fuszenecker/DiplomaThesis/CD/Fuszenecker_R_ajljxa_2009/Összefoglalás.rtf

Nagyteljesítményű vészhelyzeti áramforrás tervezése
Összefoglalás
Ez a dolgozat azért született, hogy leírjam, miként terveztem és valósítottam meg a specifikációban meghatározott DC/DC konvertert és az ahhoz szorosan kapcsolódó ellenőrző-irányító rendszert.
Maga a DC/DC konverter egy kapcsoló üzemű, push-pull felépítésű áramhatárolt feszültséggenerátor, amely amellett, hogy a bejövő 240-300 V-os DC feszültségből 300 V DC-t állít elő a kimenetén, távolról irányítható is egy felhasználói program, vagy más vezérlő segítségével. Energiatárolásra szuperkapacitásokat használok, melyek tulajdonképpen igen nagy kapacitású kondenzátorok. A tárolt energia értéke könnyen kiszámítható a szakdolgozatom 4. fejezetében található képletek segítségével. Normál üzemben a szuperkapacitás blokkot egy megfelelően felépített tápegység, mint feszültséghatárolt áramgenerátor tölti. A dolgozat fő témája ennek a DC/DC konverternek (átalakítónak) a megtervezése és megépítése.
A tápegység egyik legkritikusabb eleme a transzformátor, ez transzformálja a bejövő feszültséget a kívánt szintre. Méretezése rendkívül fontos részét képezi a dolgozatnak. A transzformátor által előállított AC feszültséget egyenirányítani és szűrni kell, hogy végül DC feszültség jelenhessen meg a konverter kimenetén. Az átalakító kimenete szuperkapacitásokra kapcsolódik, a töltőáram és a kondenzátorok kapocsfeszültségét figyelembe véve a mikrovezérlő elvégzi a szabályozást.
Az elkészített berendezés egy vészhelyzeti tápenergia-ellátás része, így gondosan kell megválasztani az áramkör részegységeit és a kommunikációs buszt. A kommunikáció megvalósításához a CAN buszt használom, mert a mikrovezérlő beépített CAN vezérlője elvégzi a keretezést, a bejövő üzenetek szűrését, priorizálását. Emellett a CAN gondoskodik arról is, hogy a kommunikáció megbízható legyen, tehát a nem nyugtázott üzenetek újraküldését automatikusan elvégzi.
Mind a DC/DC konverterben, mind a soros-CAN átalakítóban az ARM Cortex-M3 típusú processzort használom. Azért választottam az ARM-ot, mert de facto szabvány a 32 bites beágyazott alkalmazások körében, kiváló a támogatottsága (C/C++ fordító, programozó szoftver, fórumok), számos gyártó ajánl ARM magos mikrovezérlőt (ST, Luminary, ATMEL, Zilog, NXP, Texas, stb.), és a Linux is lefordítható ARM processzorra. Az ARM Cortex-M3 mag használata mellett szól az az érv is, hogy nagy teljesítményű, kifejezetten mikrovezérlőt alkalmazó beágyazott rendszerek számára fejlesztették ki, a lapkagyártók pedig számos perifériával látták el, így jelenleg a technológia csúcsát képviseli. CAN vezérlő is helyet kapott a perifériák között: természetesen magam is a mikrovezérlő beépített CAN kontrollerét használom mind a soros-CAN átalakító megvalósításához, mind a DC/DC konverter megépítéséhez.
Bátran állíthatom, hogy az elkészült áramkör a specifikációban megfogalmazott igényeket maradéktalanul kielégíti, sőt, bőven túl is teljesíti azokat.

Design of a high-power
emergency supply
Abstract
I wrote this document to show, how I designed and realized a high-power DC/DC converter and it's control system specified in the first chapter of my diploma thesis.
The DC/DC converter is a current-limited switching mode voltage source using push-pull architecture. This generator, which converts the incoming 240-300 V DC voltage to 300 V, can be remotely controlled with a user program or an other controller. Supercapacitors have been used to store energy. Theoretically, they are normal capacitors with very big capacitance. The stored energy can be calculated using the equations that can be seen in the 4th chapter of the thesis. In normal cases the supercapacitor blocks are charged by a well-designed power supply, which is a voltage limited current source. The topic of this diploma thesis is to design and build this power source.
One of the most critical components of the converter is the transformer, that transforms the input voltage to the desired output value. The design of this transformer is a very important part of the dissertation. The AC voltage provided by the transformer has to be rectified and filtered, so that the DC voltage can appear on the output of the DC/DC converter. The output of the converter has been connected to the terminals of the supercapacitors, thus the microcontroller can do the regulation according to the charging current and the voltage of the capacitors.
This equipment will be a part of an emergency power supply, so the components of the circuit and the communication bus have to be chosen carefully. To realize the communication method I use the CAN bus, because the built-in controller of the ARM processor can do the framing automatically, filters the input messages, and priorizes them. The CAN also provides a reliable communication, because it resends the not acknowledged frames.
Both the DC/DC converter and the serial-CAN interface uses an ARM Cortex-M3 processor based microcontroller. It was a really good choice, because it is the de facto standard among the 32-bit embedded applications. It has an excellent support (C/C++ compiler, programming and debugging software, forums), several chip manufacturers provides ARM based microcontrollers (ST, Luminary, ATMEL, Zilog, NXP, Texas, etc.), also the Linux can be compiled for ARM architecture. It's fruitful to use the ARM Cortex-M3 core, because of its high performance, and the manufacturers integrated the core with a couple of peripherals, so the ARM Cortex-M3 represents the top of the technology. Also the CAN controller has been integrated into the microcontroller chip, that's why I used the built-in CAN peripheral as a communication interface.
I can bravely declare that the circuit accords to the specification described in the first chapter of my diploma thesis. Moreover, it eclipses the specification.
