fuszenecker/DiplomaThesis/Presentation/Presentation.pdf

Nagyteljesítményű vészhelyzeti áramforrás tervezése

## Nagy teljesítményű vészhelyzeti áramforrás tervezése

Fuszenecker Róbert
2009. február 25.
Készítette: Fuszenecker Róbert 2009-ben. | 1 / 29

Nagyteljesítményű vészhelyzeti áramforrás tervezése

## A feladat megfogalmazása

Az EADS¹
specifikációjának megfelelően készítendő egy vészhelyzeti áramforrás, mely
az elsődleges áramforrás kimaradása esetén átveszi annak funkcióját:
10 kW terhelést
legalább 10 másodpercig táplál
270 VDC névleges bemenő és kimenő feszültség mellett, szuperkapacitásokat tartalmaz,
távolról vezérelhető és ellenőrizhető (CAN buszon keresztül).

1 European Aeronautic Defence and Space Company EADS N.V.

Készítette: Fuszenecker Róbert 2009-ben. | 2 / 29

Nagyteljesítményű vészhelyzeti áramforrás tervezése

## A tápegység felépítése

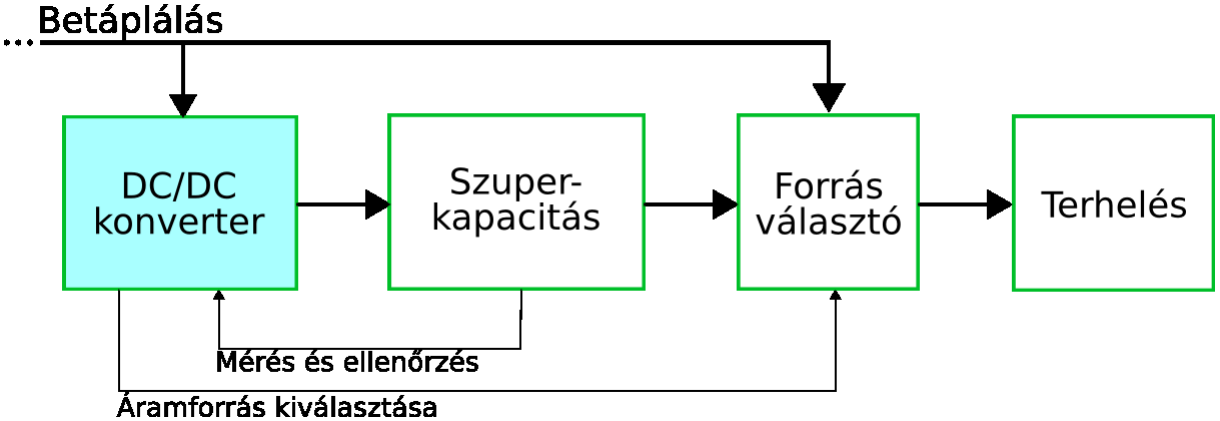
[picture p1: figure]

Készítette: Fuszenecker Róbert 2009-ben. | 3 / 29

Nagyteljesítményű vészhelyzeti áramforrás tervezése

## Részfeladatok

Az áramforrás megvalósításának lépései: tervezés
szuperkapacitás megválasztása töltő-áramkör architektúrájának kiválasztása transzformátor méretezése
áramkör megépítése
soros-CAN átalakító megvalósítása töltő-áramkör megépítése
mérés, ellenőrzés
Készítette: Fuszenecker Róbert 2009-ben. | 4 / 29

Nagyteljesítményű vészhelyzeti áramforrás tervezése

## Szuperkapacitás kiválasztása

A kondenzátorban tárolt energia a következő képlettel számítható:

∫t

# Ptdt=

1
2

⋅C⋅U0

2−U1

2

Az áramkör megépítéséhez egy 6,173 F kapacitású, 300 V-os kondenzátort kell használni. A gyakorlatban ez 5 darab 84 V-os, 100 F-os változattal oldható meg.

Készítette: Fuszenecker Róbert 2009-ben. | 5 / 29

Nagyteljesítményű vészhelyzeti áramforrás tervezése

## A kondenzátorok töltése

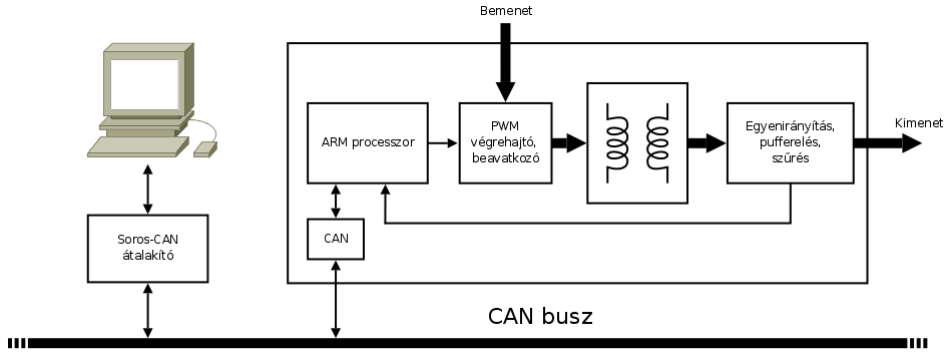
[picture p2: figure]

Az eszköz egy feszültséghatárolt áramgenerátorként vagy áramhatárolt feszültséggenerátorként működik.

Készítette: Fuszenecker Róbert 2009-ben. | 6 / 29

Nagyteljesítményű vészhelyzeti áramforrás tervezése

## Architektúraválasztás

A képen egy push-pull felépítésű, kapcsoló üzemű tápegység látható.

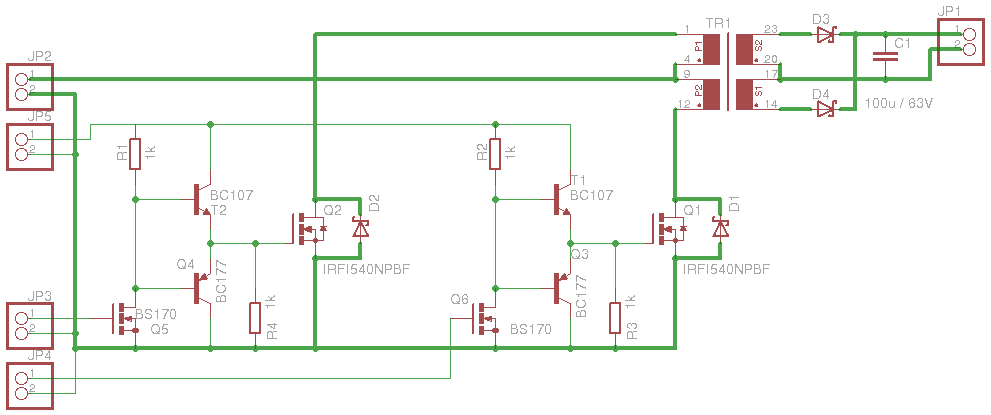
[picture p3: figure]

Készítette: Fuszenecker Róbert 2009-ben. | 7 / 29

Nagyteljesítményű vészhelyzeti áramforrás tervezése

## A kimenő feszültség előállítása

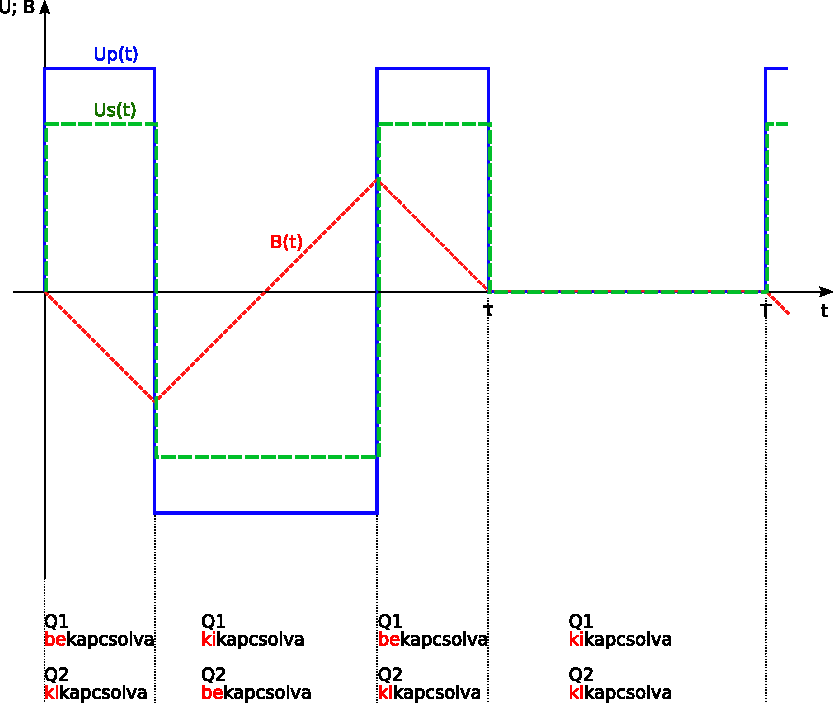
[picture p4: figure]

Készítette: Fuszenecker Róbert 2009-ben. | 8 / 29

Nagyteljesítményű vészhelyzeti áramforrás tervezése

## A kimenő feszültség előállítása (folyt.)

A képen látható jelalakot egy ARM Cortex-M3 alapú mikrovezérlő (STM32F103CBT6) megszakítási rutinja állítja elő, mint szoftver PWM jelet.

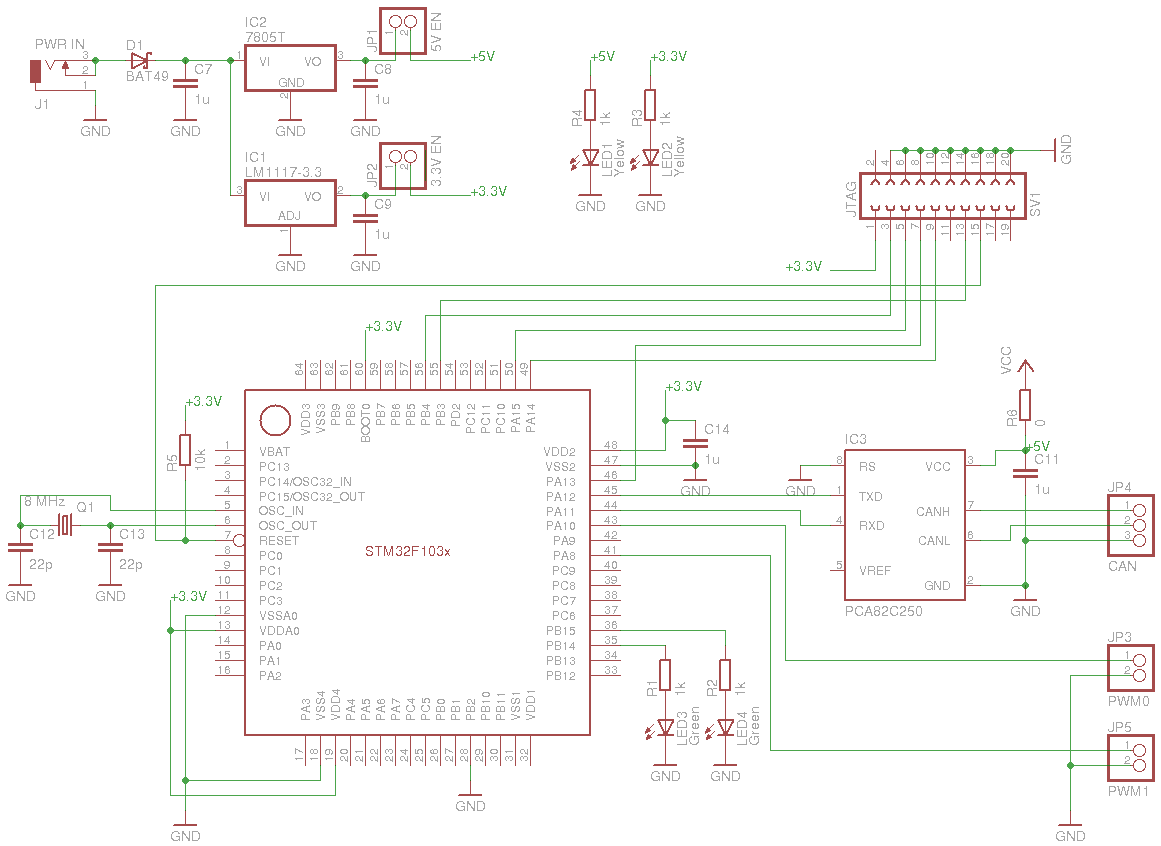
[picture p5: figure]

Készítette: Fuszenecker Róbert 2009-ben. | 9 / 29

Nagyteljesítményű vészhelyzeti áramforrás tervezése

## A transzformátor méretezése

A transzformátor méretezéséhez szükséges összefüggéseket a Maxwell-egyenletekből vezettem le. Ezek közül a legfontosabb:

∮s

H⋅d

s=−

d

# dt ∫A

# Bt⋅d

A

Ez az egyenlet teremt kapcsolatot az indukcióváltozás és az indukált feszültség között.

Készítette: Fuszenecker Róbert 2009-ben. | 10 / 29

Nagyteljesítményű vészhelyzeti áramforrás tervezése

## Az „Y” paraméter

A transzformátor vasmagja jellemezhető egy olyan paraméterrel, amely csak
a primer feszültség jelalakjától,
a maximális indukciótól (katalógusadat), a vasmag keresztmetszetétől
és az alkalmazott frekvenciától
függ:
Y=

Up
Np

=

Us
Ns

=k⋅B

## ⋅A⋅f min

Készítette: Fuszenecker Róbert 2009-ben. | 11 / 29

Nagyteljesítményű vészhelyzeti áramforrás tervezése

## Transzformátorok párhuzamosítása

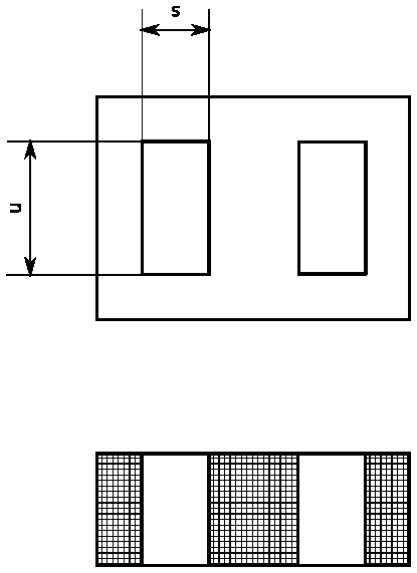
[picture p6: figure]
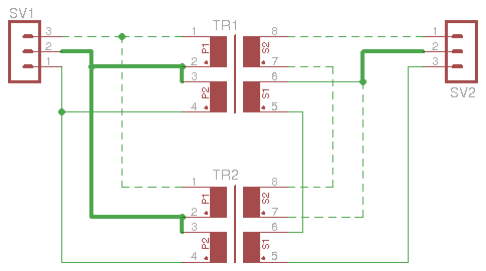
[picture p7: figure]

Erre azért van szükség, mert egy vasmagon nem fér el a teljes tekercselés.

Készítette: Fuszenecker Róbert 2009-ben. | 12 / 29

Nagyteljesítményű vészhelyzeti áramforrás tervezése

## Kommunikáció CAN buszon keresztül

Az áramköröm megvalósításakor a CAN busz alkalmazása mellett döntöttem, mert
viszonylag zavarérzékeny,
nagy átviteli sebességet biztosít (max. 1 Mbit/s),
busz topológia valósítható meg,
a CAN vezérlő tehermentesíti a processzort, mert elvégzi a keretezési feladatokat, pl.:
üzenetprioritás, szűrők
nyugtázás és újrakérés, hibakezelés (vételi puffer megtelt) hibaellenőrzés (CRC)
Készítette: Fuszenecker Róbert 2009-ben. | 13 / 29

Nagyteljesítményű vészhelyzeti áramforrás tervezése

## A CAN protokoll rövid áttekintése

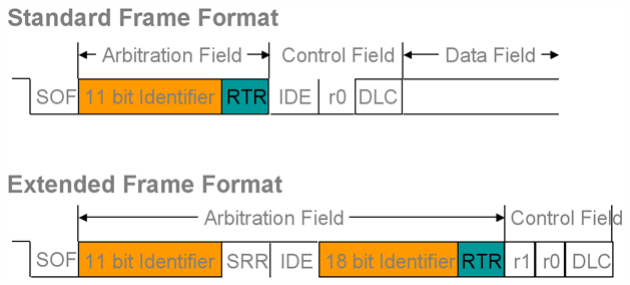
[picture p8: figure]

Készítette: Fuszenecker Róbert 2009-ben. | 14 / 29

Nagyteljesítményű vészhelyzeti áramforrás tervezése

## Busz topológia kialakítása

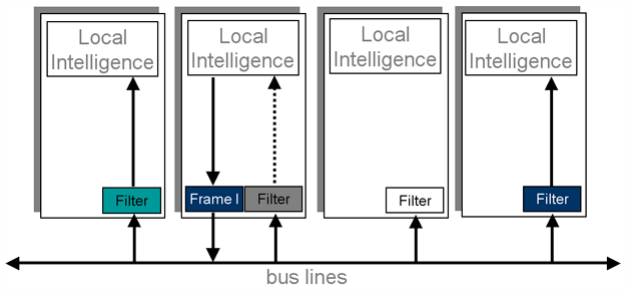
[picture p9: figure]

Készítette: Fuszenecker Róbert 2009-ben. | 15 / 29

Nagyteljesítményű vészhelyzeti áramforrás tervezése

## Az átalakító felépítése

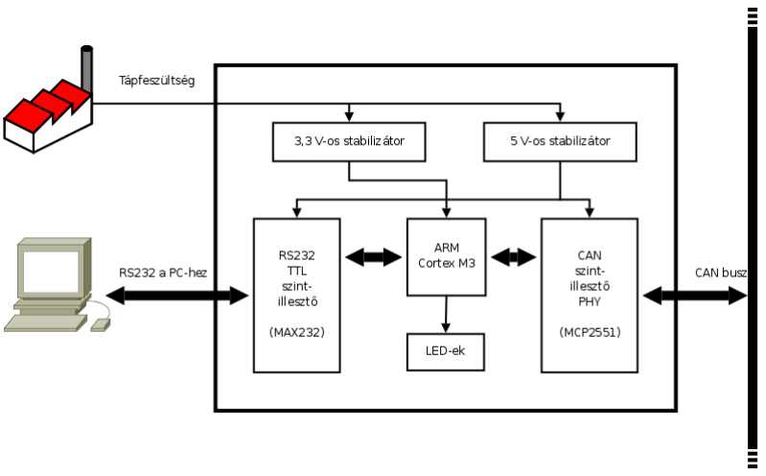
[picture p10: figure]

Készítette: Fuszenecker Róbert 2009-ben. | 16 / 29

Nagyteljesítményű vészhelyzeti áramforrás tervezése

## Az átalakító felépítése (folytatás)

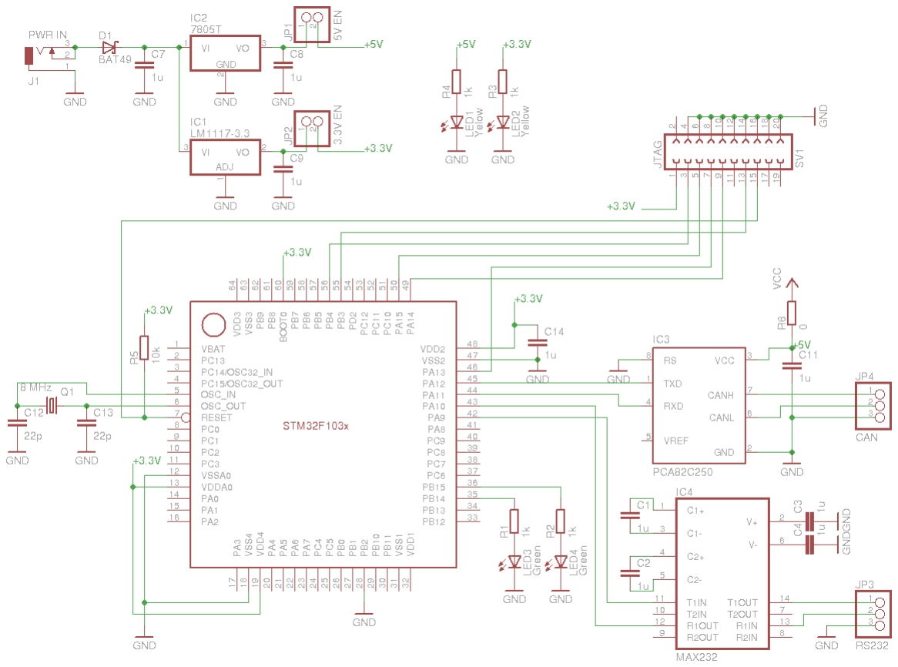
[picture p11: figure]

Készítette: Fuszenecker Róbert 2009-ben. | 17 / 29

Nagyteljesítményű vészhelyzeti áramforrás tervezése

## Az ARM processzor

Mind a tápegység, mind a soros-CAN átalakító megvalósításához egy ARM Cortex-M3 alapú mikrovezérlőt (STM32F103CBT6) használtam a következő okok miatt:
32 bites felépítésű
4 gigabájtos lineáris címtartománnyal rendelkezik (nem kell memóriabankokat és I/O utasításokat használni),
32 bites ARM és 16 bites Thumb utasítások végrehajtására is képes (a Cortex-M3 csak a Thumb2-t ismeri)
a processzor több futtatási módot tartalmaz: lehetőség van a rendszer- és a felhasználói kód szétválasztására. Ez növeli a beágyazott rendszer biztonságát és megbízhatóságát,
Készítette: Fuszenecker Róbert 2009-ben. | 18 / 29

Nagyteljesítményű vészhelyzeti áramforrás tervezése

## Az ARM processzor (folytatás)

számos egységet beépítve tartalmaz: MMU-t, ETM-et, megszakításkezelőt, SYSTICK számlálót,
a gyártók még számos perifériával egészítik ki a processzor magot: számlálókkal, DMA-val, kommunikációs eszközökkel (CAN, Ethernet, USB, USART, I²C, SPI, SD/MMC), A/D és D/A átalakítókkal, stb.,
kiváló szoftveres támogatással rendelkezik: a GCC fordít ARM processzorra, az OpenOCD pedig számos gyártó termékét támogatja.
Firmware library: eszközök kezeléséhez, szabályozástechnikai (pl. PID) és DSP algoritmusok (pl. FIR, IIR, FFT, Speex), TCP/IP és UDP/IP verem
Készítette: Fuszenecker Róbert 2009-ben. | 19 / 29

Nagyteljesítményű vészhelyzeti áramforrás tervezése

## Az ARM Cortex-M3 processzor felépítése

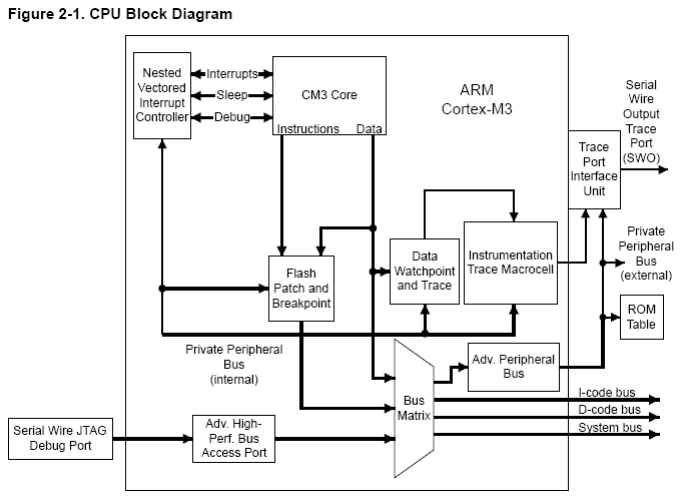
[picture p12: figure]

Készítette: Fuszenecker Róbert 2009-ben. | 20 / 29

Nagyteljesítményű vészhelyzeti áramforrás tervezése

## Az STM32F103CBT6 mikrovezérlő

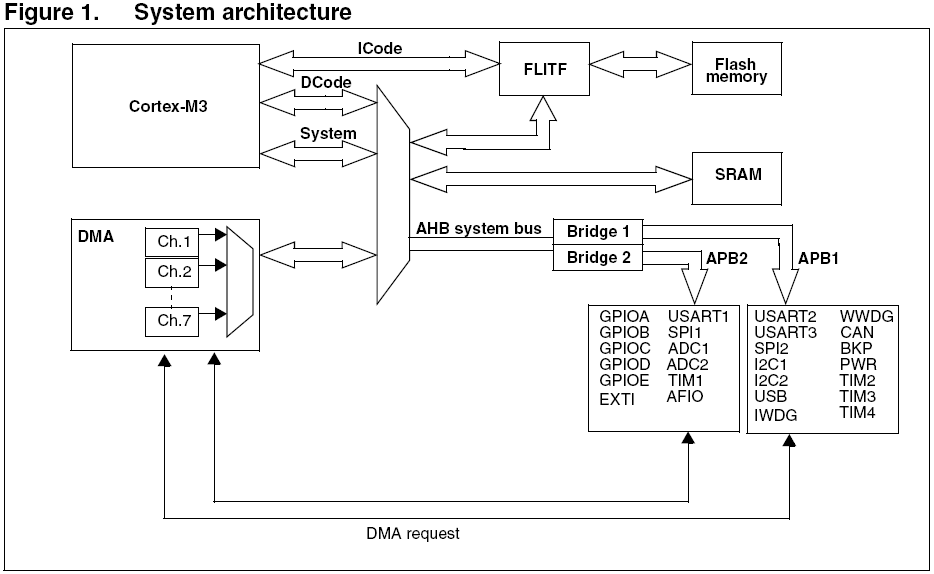
[picture p13: figure]

Készítette: Fuszenecker Róbert 2009-ben. | 21 / 29

Nagyteljesítményű vészhelyzeti áramforrás tervezése

## A szoftverfejlesztés

Az áramforrás és a soros-CAN átalakító elkészítéséhez a következő szoftver eszközöket használtam:
binutils, gcc, make – keresztfordító (cross compiler) a C programok fordításához,
az ST által biztosított függvénykönyvtár a beépített eszközök kezeléséhez,
gdb, openocd – a lefordított kód hibamentesítéséhez,
minicom – a soros-CAN átalakítóval való kommunikációhoz, python – a soros-CAN átalakító felhasználói felületének elkészítéséhez,
ez utóbbi szolgál a tápegységgel való kommunikációhoz is.
Készítette: Fuszenecker Róbert 2009-ben. | 22 / 29

Nagyteljesítményű vészhelyzeti áramforrás tervezése

## A soros-CAN átalakító működés közben

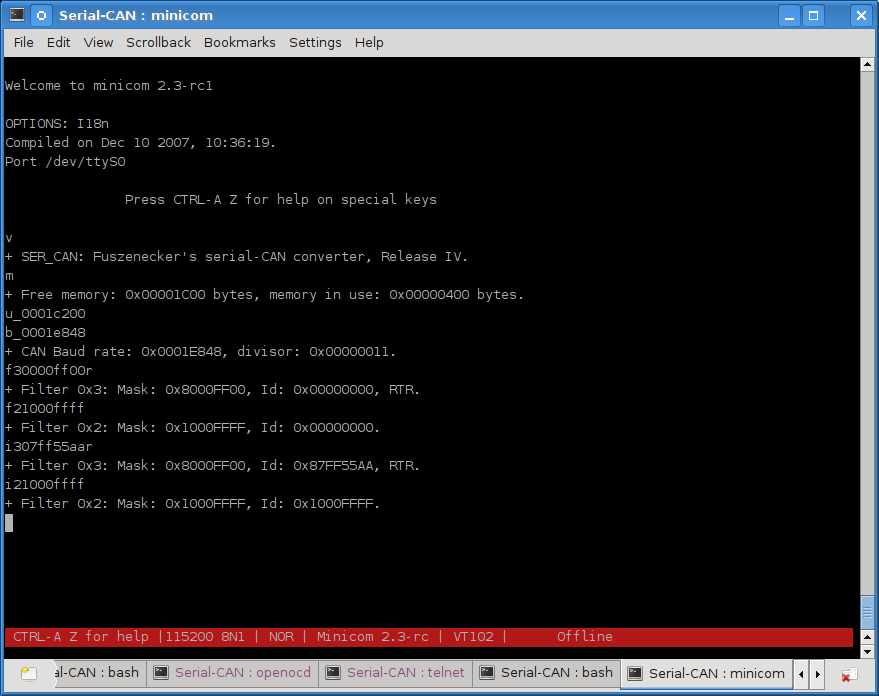
[picture p14: figure]

Készítette: Fuszenecker Róbert 2009-ben. | 23 / 29

Nagyteljesítményű vészhelyzeti áramforrás tervezése

## A grafikus felhasználói felület

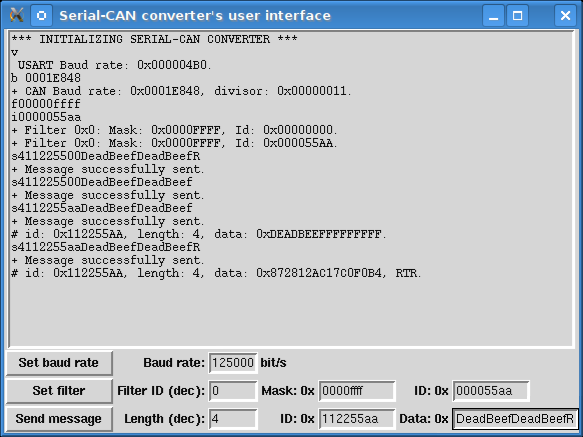
[picture p15: figure]

Készítette: Fuszenecker Róbert 2009-ben. | 24 / 29

Nagyteljesítményű vészhelyzeti áramforrás tervezése

# Van-e kérdés az elhangzottakkal kapcsolatban?

Készítette: Fuszenecker Róbert 2009-ben. | 25 / 29

Nagyteljesítményű vészhelyzeti áramforrás tervezése

# Köszönöm a figyelmet!

Készítette: Fuszenecker Róbert 2009-ben. | 26 / 29

Nagyteljesítményű vészhelyzeti áramforrás tervezése

## Felhasznált szoftverek

OpenOffice.org 2.4.1 – szövegszerkesztő, szövegformázó
GCC 4.2.3 (Sourcery G++ Lite 2008q1-126) – GNU Compiler Collection (GNU fordítógyűjtemény)
Dia 0.96.1 – diagram szerkesztő
Inkscape 0.46 – vektorgrafikus szerkesztő
OpenOCD – Open On-Chip Debugger (nyílt lapkán belüli nyomkövető)
STM32 Firmware Library – STM32 beágyazott programkönyvtár Eagle 5.3.0 Light Edition – nyomtatott áramkör tervező
Készítette: Fuszenecker Róbert 2009-ben. | 27 / 29

Nagyteljesítményű vészhelyzeti áramforrás tervezése

## Felhasznált irodalom

Cortex™-M3 Technical Reference Manual – műszaki referencia kézikönyv
RM0008 STM32 Reference Manual – STM32 referencia kézikönyv http://wikipedia.org/ – A szabad enciklopédia (az ARM processzorok története)
http://www.softing.com – a CAN busz képeinek forrása
Készítette: Fuszenecker Róbert 2009-ben. | 28 / 29

Nagyteljesítményű vészhelyzeti áramforrás tervezése

## Az engedély

Dear Mr Fuszenecker,
we are very pleased that you selected the STM32 for your study. We confirm you hereby that you can use any part of our documentation to illustrate your Report.
We are always interested to see how our product are used. Would it be possible to receive also a copy of your work (or part of it)?

Best regards,
Thomas Ensergueix
Marketing Manager Microcontrollers
Készítette: Fuszenecker Róbert 2009-ben. | 29 / 29
