fuszenecker/DiplomaThesis/Documentation/acknowledge-field.gif

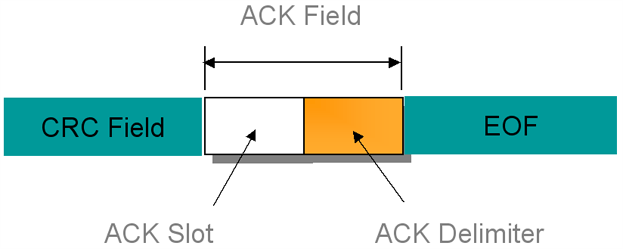
Documentation/acknowledge-field.gif
