fuszenecker/DiplomaThesis/Documentation/arbitration-field.gif

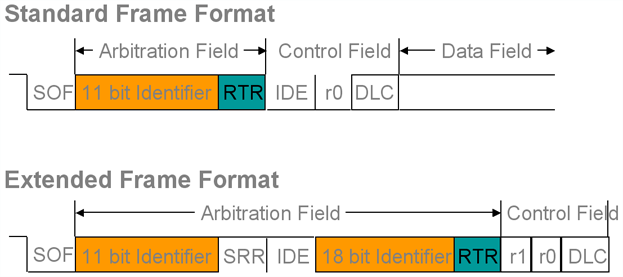
Documentation/arbitration-field.gif
