fuszenecker/DiplomaThesis/Documentation/Arch1.png

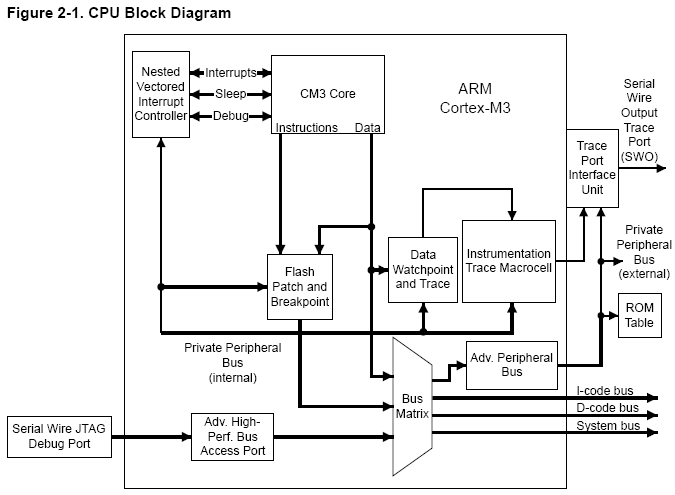
Documentation/Arch1.png
