fuszenecker/DiplomaThesis/Documentation/broadcast-communication.gif

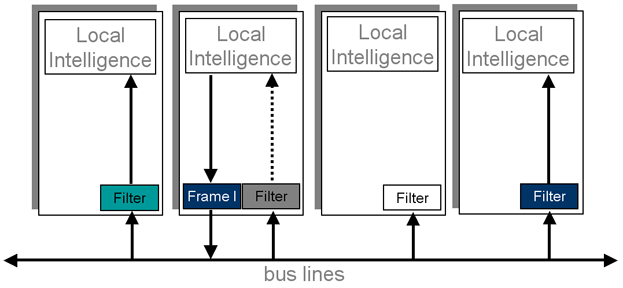
Documentation/broadcast-communication.gif
