fuszenecker/DiplomaThesis/Documentation/BUt.png

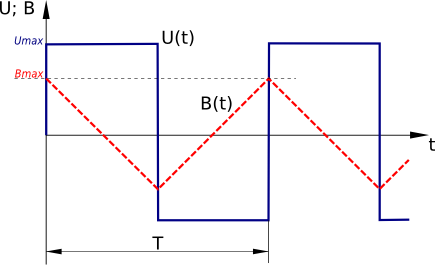
Documentation/BUt.png
