fuszenecker/DiplomaThesis/Documentation/cal.png

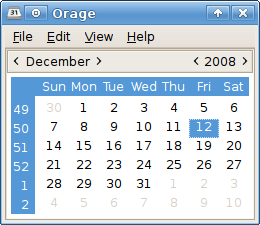
Documentation/cal.png
