fuszenecker/DiplomaThesis/Documentation/Capacitor.png

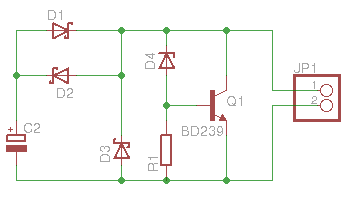
Documentation/Capacitor.png
