fuszenecker/DiplomaThesis/Documentation/data-field.gif

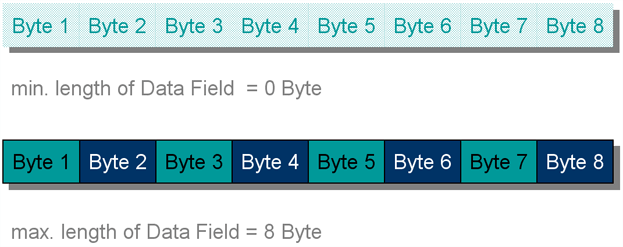
Documentation/data-field.gif
