fuszenecker/DiplomaThesis/Documentation/gdb3.png

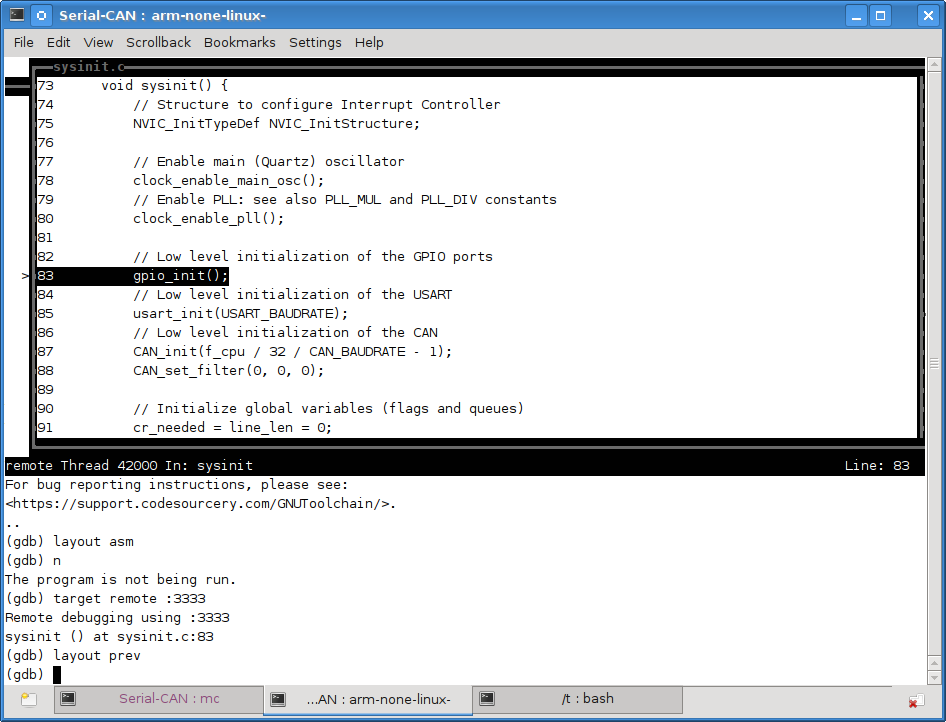
Documentation/gdb3.png
