fuszenecker/DiplomaThesis/Documentation/gdb4.png

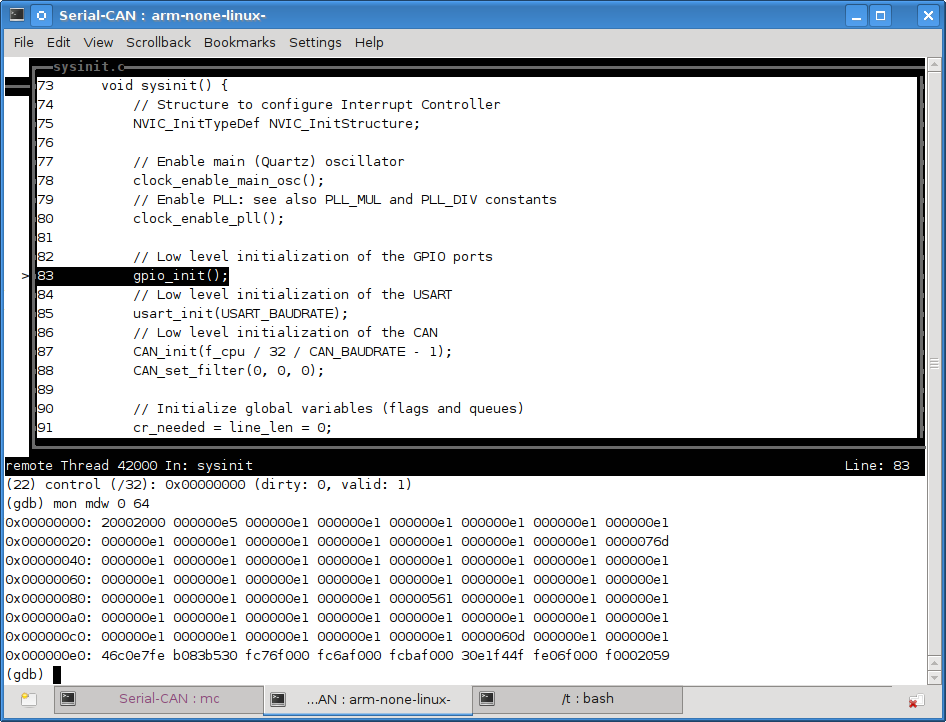
Documentation/gdb4.png
