fuszenecker/DiplomaThesis/Documentation/iso-11992.gif

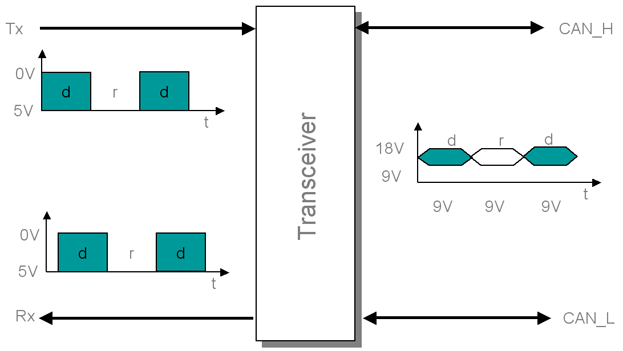
Documentation/iso-11992.gif
