fuszenecker/DiplomaThesis/Documentation/jtagwigglersch.png

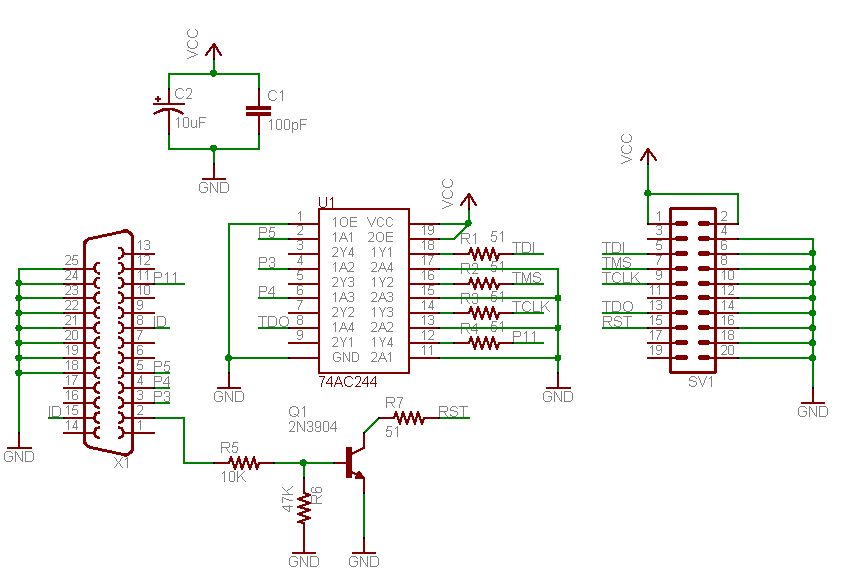
Documentation/jtagwigglersch.png
