fuszenecker/DiplomaThesis/Documentation/lin_bu1.gif

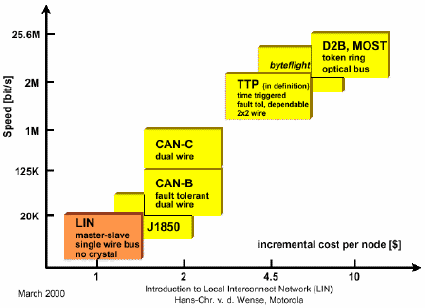
Documentation/lin_bu1.gif
