fuszenecker/DiplomaThesis/Documentation/mini-style-connector.gif

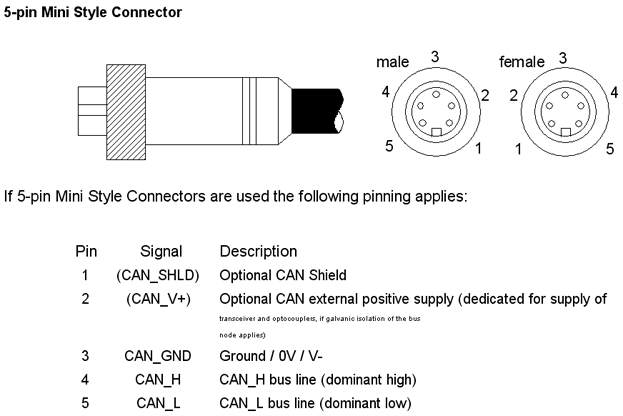
Documentation/mini-style-connector.gif
