fuszenecker/DiplomaThesis/Documentation/Minicom09.png

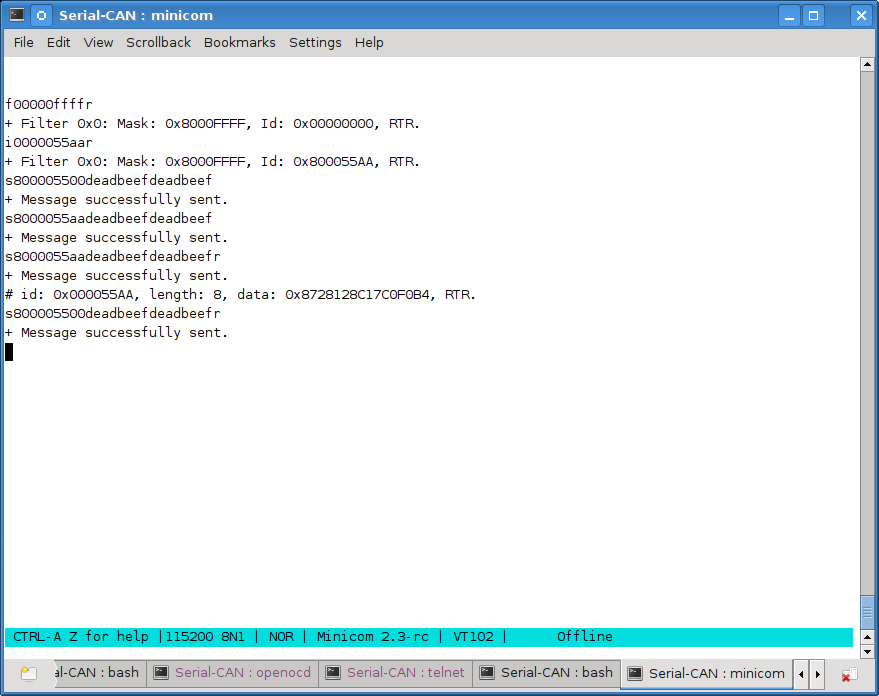
Documentation/Minicom09.png
