fuszenecker/DiplomaThesis/Documentation/Minicom10.png

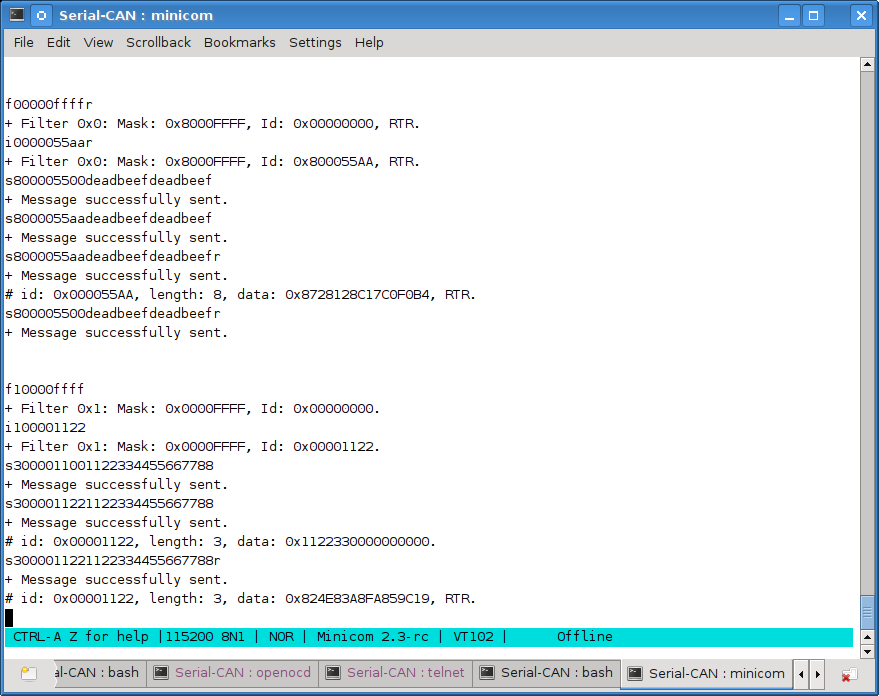
Documentation/Minicom10.png
