fuszenecker/DiplomaThesis/Documentation/Minicom11.png

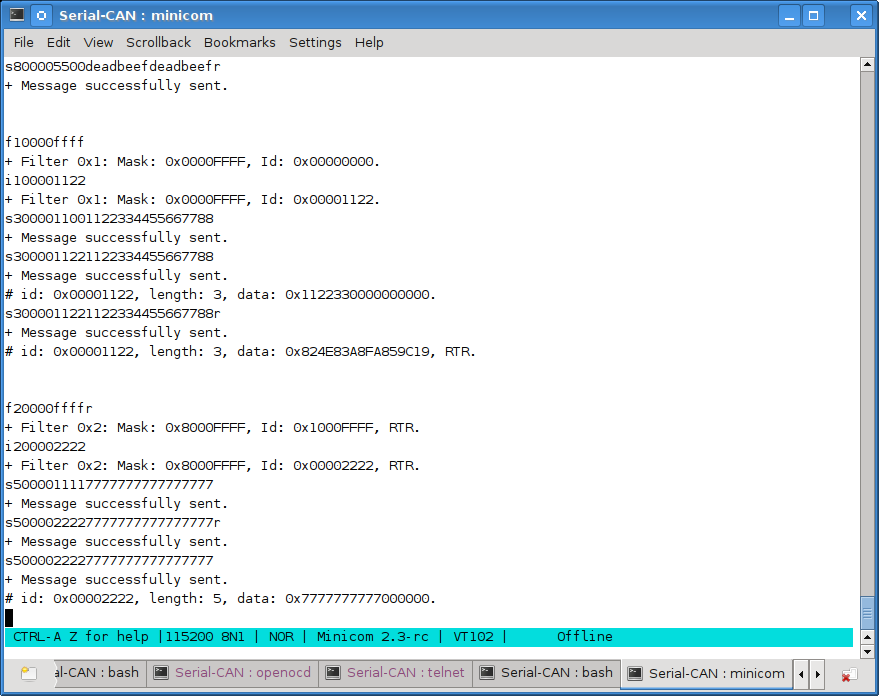
Documentation/Minicom11.png
