fuszenecker/DiplomaThesis/Documentation/multiple-bus-access.gif

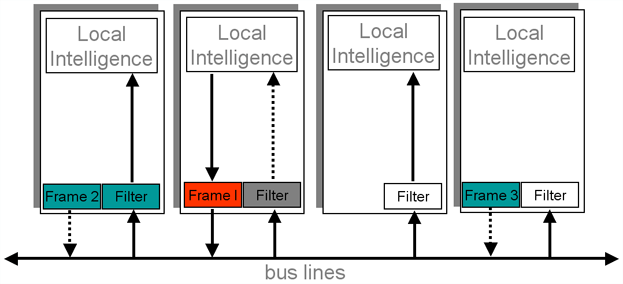
Documentation/multiple-bus-access.gif
