fuszenecker/DiplomaThesis/Documentation/open-style-connector.gif

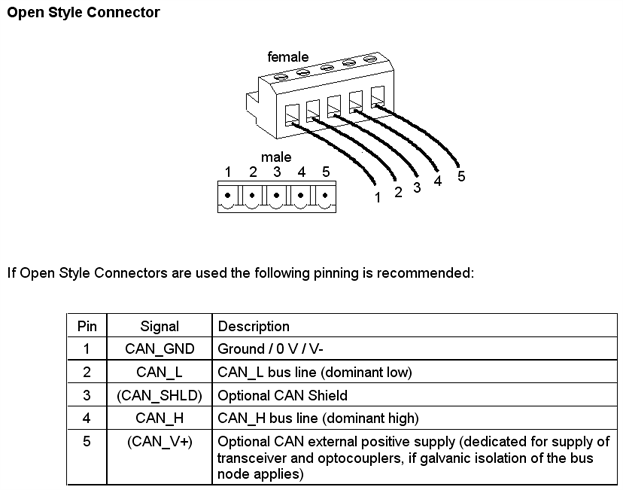
Documentation/open-style-connector.gif
