fuszenecker/DiplomaThesis/Documentation/PCB_SC.png

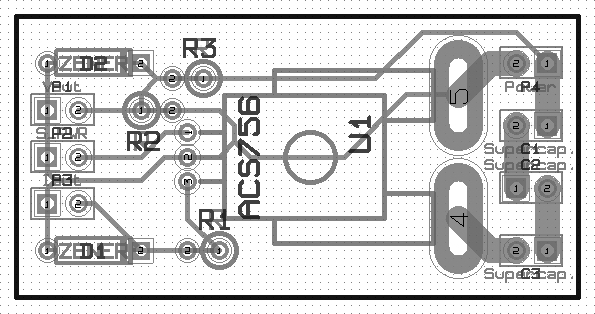
Documentation/PCB_SC.png
