fuszenecker/DiplomaThesis/Documentation/pin-assignment.gif

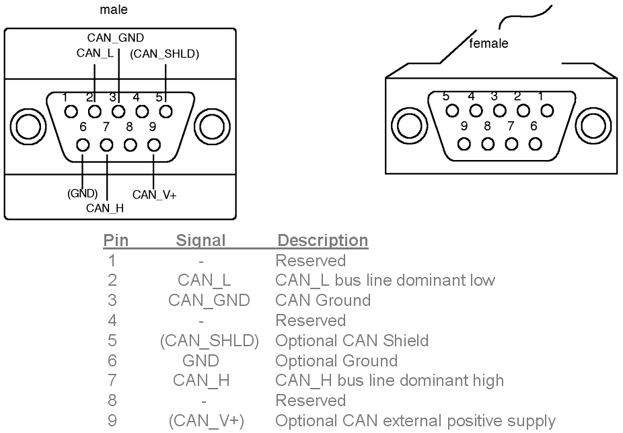
Documentation/pin-assignment.gif
