fuszenecker/DiplomaThesis/Documentation/remote-request.gif

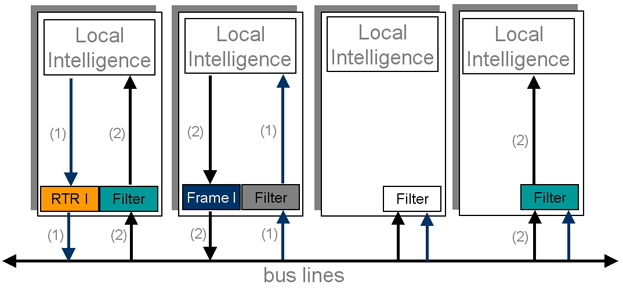
Documentation/remote-request.gif
