fuszenecker/DiplomaThesis/Documentation/UI_00.png

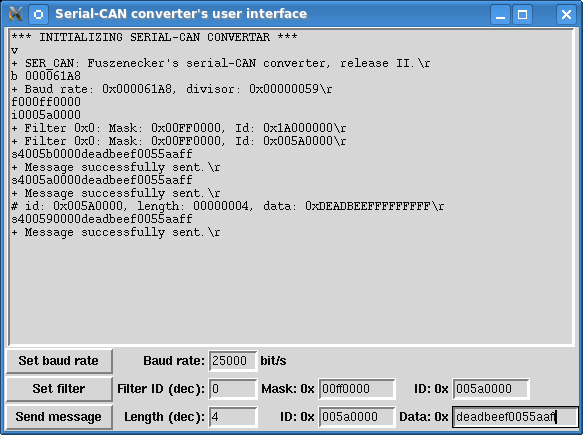
Documentation/UI_00.png
