fuszenecker/DiplomaThesis/Documentation/UI_01.png

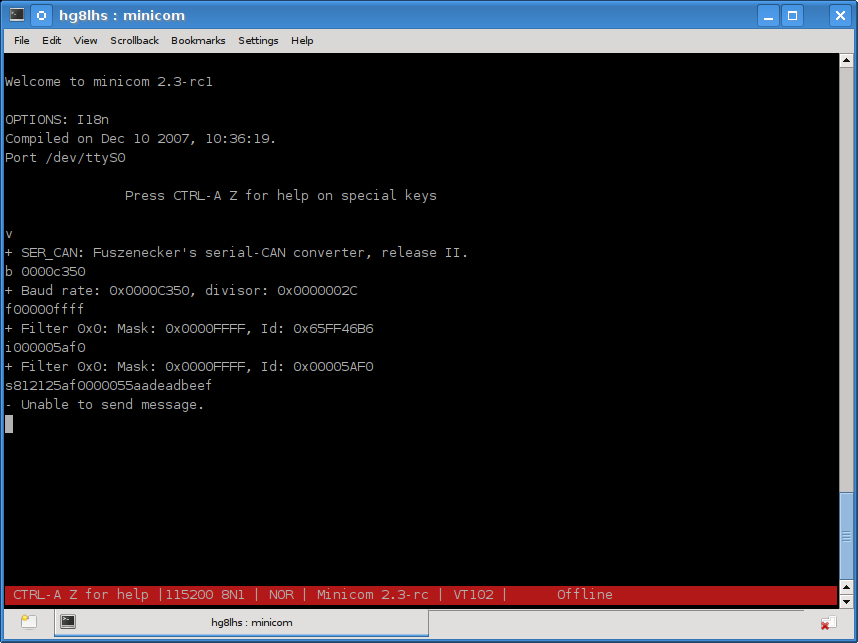
Documentation/UI_01.png
