fuszenecker/DiplomaThesis/Documentation/vasmag.png

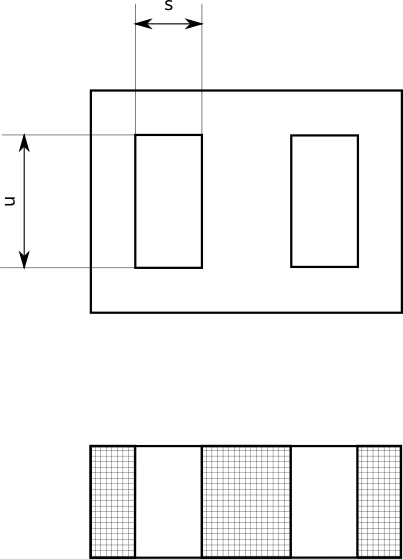
Documentation/vasmag.png
