fuszenecker/DiplomaThesis/Documentation/VBt.png

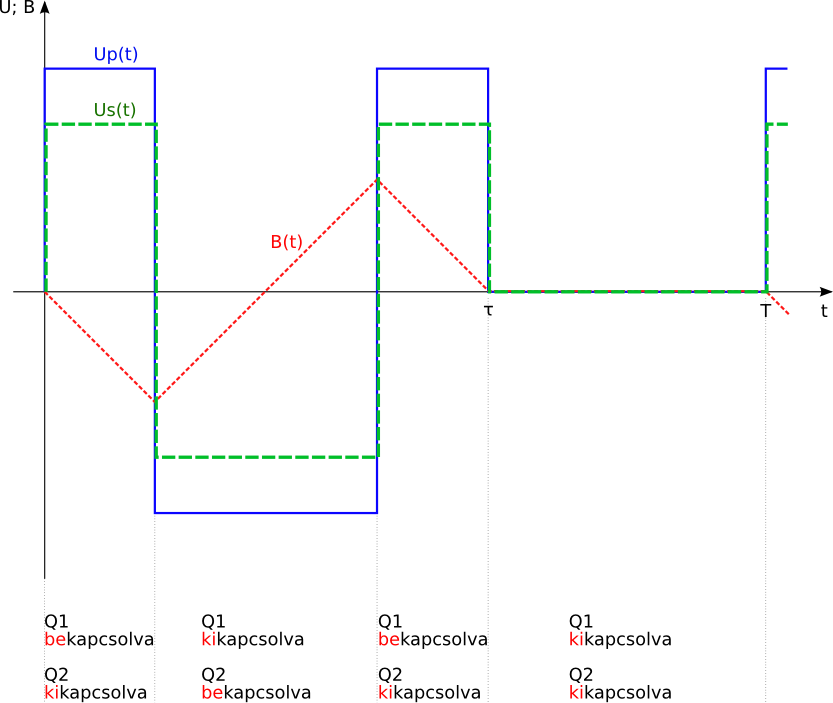
Documentation/VBt.png
