fuszenecker/DiplomaThesis/Documentation/Supercap/test.sch

## KiCad design Documentation/Supercap/test.sch (2008-12-20)

Schematic: test.sch

Parts:
C1, C2, C3: Supercap.
D1, D2: ZENER
P1: Vout
P2: S_PWR
P3: Iout
P4: Power
R1, R2, R3: R
U1: ACS756
