fuszenecker/DiplomaThesis/(commit log)

2008-08-29 Added "Diploma témák.odt" Diploma Thesis Topics.
    [Diploma témák.ods]
2008-09-01 Added a lot of pictores from http://www.softing.com/home/en/industrial-automation/products/can-bus/more-can-bus/communication/broadcast.php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
2008-09-05 Added new version of "Diploma témák".
    [Diploma témák.ods]
2008-10-02 Added Remote frame (RTR) support
2008-10-02 Added RTR (remote frame) support and 29 bit ID-s forced.
2008-10-04 Added RTR (remote frame) and USART baud rate selection. Additional tests. Security bit is used to protect the FLASH memory.
2008-10-26 Added PWM.
2008-11-02 Modified PWM (now using SW PWM).
2008-11-06 Pre-release backup.
    [DCDC converter.sch, main.sch]
2008-11-10 Released 0.26 Added few schematics.
    [main.brd, main.sch, pwm.sch]
2008-11-11 Released 0.27
    [Transformers.sch, main.brd, main.sch, pwm.sch]
2008-11-12 Added Capacitor.png and Capacitor.sch
    [Capacitor.sch]
2008-11-12 Released 0.28 Added capacitor protection.
2008-11-23 Added ADC support.
2008-11-23 Added (maybe working) ADC support.
2008-11-25 ADC initialization fixes.
2008-12-10 Added few hardware files.
    [pwm.sch]
2008-12-20 New files.
    [test.sch]
2008-12-20 Added small PCB of the current sensor.
    [test.brd, test.sch]
2008-12-29 Added new files. Changed black bg of images. New supercapacitor schematics.
2008-12-31 First "pre-final" release. Lot of spell-checking have been done.
    [Diploma témák.ods]
